zazachubin/RD53B_Quad_6DP_to_ERF8_Data_Adapter/Docs/Design/PCB_Design/6DP_to_ERF8_pcb_GND.png

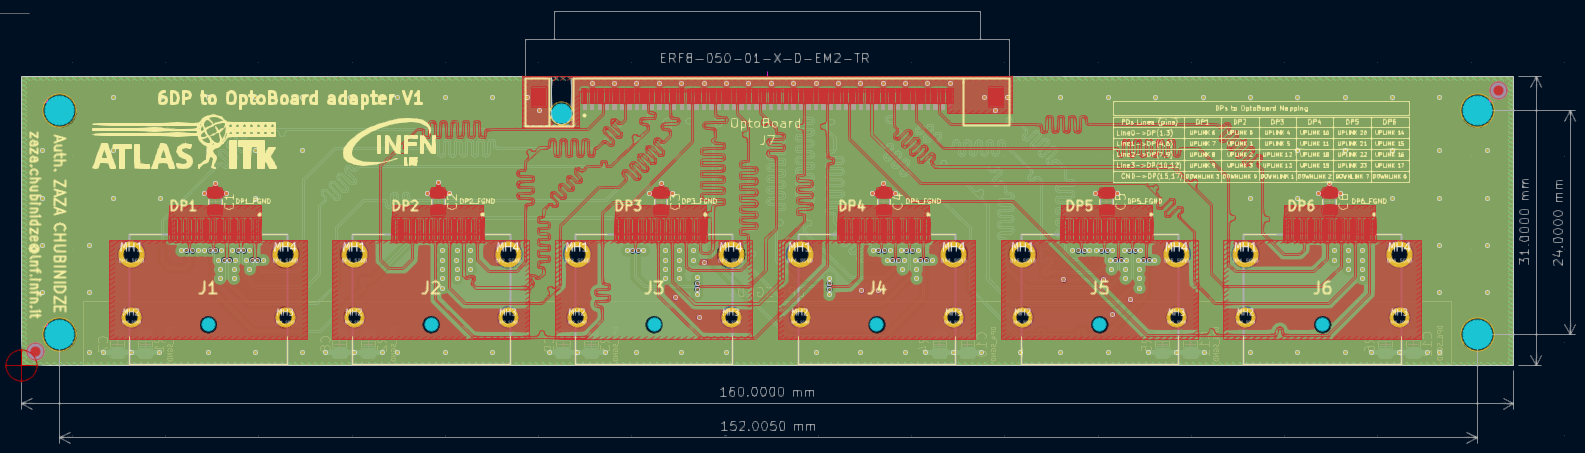
Docs/Design/PCB_Design/6DP_to_ERF8_pcb_GND.png
