zazachubin/RD53B_Quad_6DP_to_ERF8_Data_Adapter/Production/Panel_Board_Gerber/Panelization_bom.csv

Id | Designator | Footprint | Quantity | Designation | Supplier and ref
1 | ,,,,,,,,,,,,,,,,,,,,,,,,,,,,,,, |  | 32
2 | C2,C2,C2,C2,C2,C2,C2,C2,C1,C1,C1,C1,C1,C1,C1,C1,C6,C6,C6,C6,C6,C6,C6,C6,C3,C3,C3,C3,C3,C3,C3,C3,C5,C5,C5,C5,C5,C5,C5,C5,C4,C4,C4,C4,C4,C4,C4,C4,C12,C12,C12,C12,C12,C12,C12,C12,C8,C8,C8,C8,C8,C8,C8,C8,C7,C7,C7,C7,C7,C7,C7,C7,C9,C9,C9,C9,C9,C9,C9,C9,C11,C11,C11,C11,C11,C11,C11,C11,C10,C10,C10,C10,C10,C10,C10,C10 | C_0805_2012Metric | 96 | 0.1uF
3 | J4,J4,J4,J4,J4,J4,J4,J4,J2,J2,J2,J2,J2,J2,J2,J2,J6,J6,J6,J6,J6,J6,J6,J6,J5,J5,J5,J5,J5,J5,J5,J5,J3,J3,J3,J3,J3,J3,J3,J3,J1,J1,J1,J1,J1,J1,J1,J1 | 472720024 | 48 | 47272-0024
4 | REF**,REF**,REF**,REF**,REF**,REF** | Fiducial | 6 | Fiducial
5 | J7,J7,J7,J7,J7,J7,J7,J7 | SAMTEC_ERF8-050-01-X-D-EM2-TR | 8 | ERF8-050-01-X-D-EM2-TR
6 | REF_Top,REF_Top,REF_Top,REF_Top,REF_Top,REF_Top,REF_Top,REF_Top,REF_Top,REF_Top,REF_Top,REF_Top,REF_Top,REF_Top,REF_Top,REF_Top,REF_Bottom,REF_Bottom,REF_Bottom,REF_Bottom,REF_Bottom,REF_Bottom,REF_Bottom,REF_Bottom,REF_Bottom,REF_Bottom,REF_Bottom,REF_Bottom,REF_Bottom,REF_Bottom,REF_Bottom,REF_Bottom | Fiducial_1mm_Mask2mm | 32 | Fiducial_1mm_Mask2mm
7 | R3,R3,R3,R3,R3,R3,R3,R3,R6,R6,R6,R6,R6,R6,R6,R6,R4,R4,R4,R4,R4,R4,R4,R4,R2,R2,R2,R2,R2,R2,R2,R2,R1,R1,R1,R1,R1,R1,R1,R1,R5,R5,R5,R5,R5,R5,R5,R5 | R_0805_2012Metric | 48 | 10k
