zazachubin/RD53B_Quad_6DP_to_ERF8_Data_Adapter/Production/Single_Board_Gerber/RD53B_Quad_6DP_to_ERF8_Data_Adapter_Bom.csv

Id | Designator | Footprint | Quantity | Designation | Supplier and ref
1 | ,,, |  | 4
2 | C2,C1,C6,C3,C5,C4,C12,C8,C7,C9,C11,C10 | C_0805_2012Metric | 12 | 0.1uF
3 | J4,J2,J6,J5,J3,J1 | 472720024 | 6 | 47272-0024
4 | J7 | SAMTEC_ERF8-050-01-X-D-EM2-TR | 1 | ERF8-050-01-X-D-EM2-TR
5 | REF_Top,REF_Top,REF_Bottom,REF_Bottom | Fiducial_1mm_Mask2mm | 4 | Fiducial_1mm_Mask2mm
6 | R3,R6,R4,R2,R1,R5 | R_0805_2012Metric | 6 | 10k
