zazachubin/RD53B_Quad_6DP_to_ERF8_Data_Adapter/Docs/Design/3D_PCB/6DP_to_ERF8_PCB_front_without_components.png

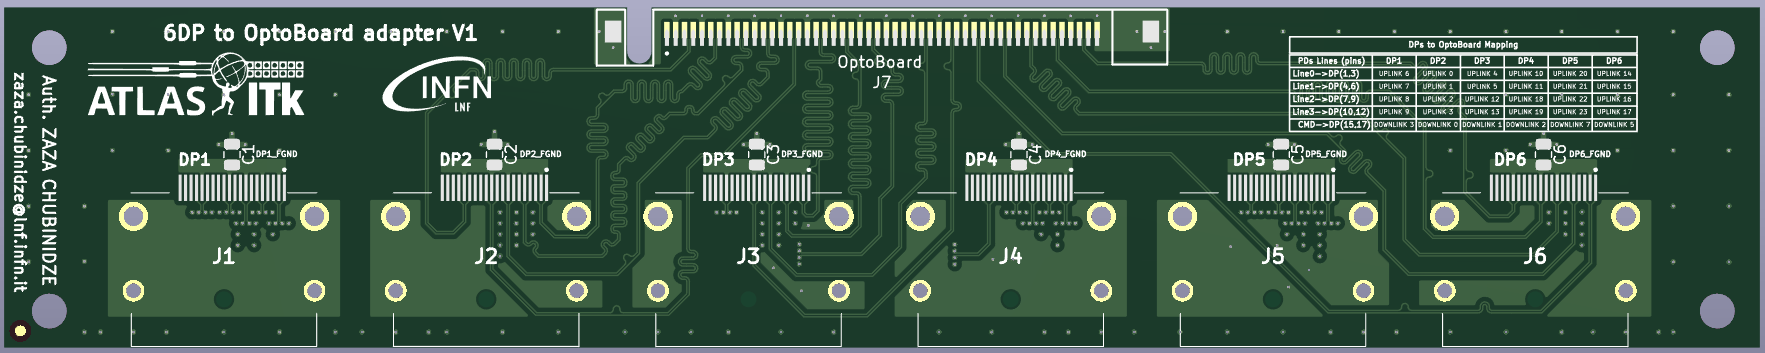
Docs/Design/3D_PCB/6DP_to_ERF8_PCB_front_without_components.png
