zazachubin/RD53B_Quad_6DP_to_ERF8_Data_Adapter/Docs/Design/Schematic/v1/RD53B_Quad_6DP_to_ERF8_Data_Adapter.pdf

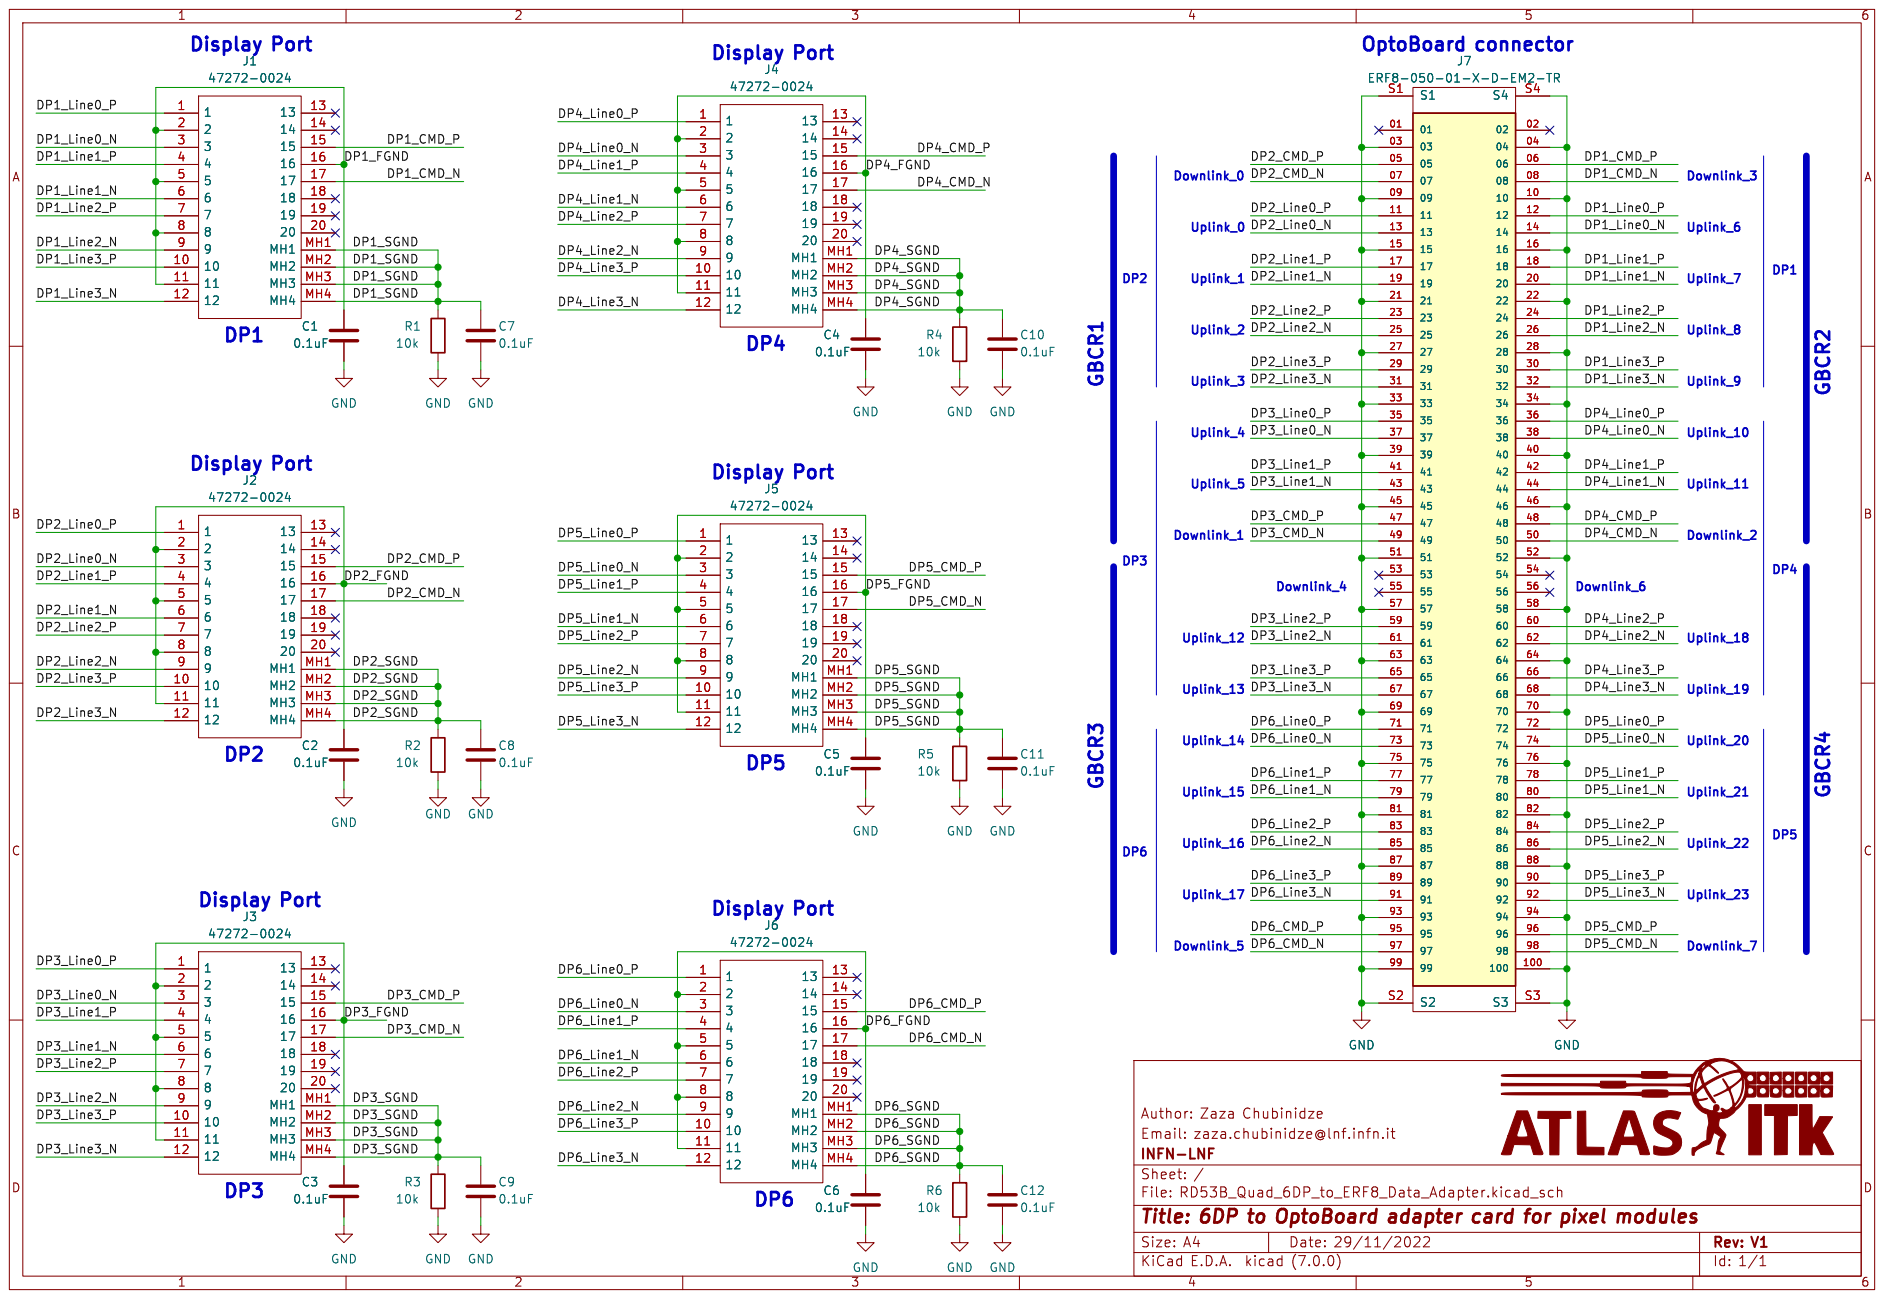
[picture p7: page 1]

INFN-LNF Email: zaza.chubinidze@lnf.infn.it Author: Zaza Chubinidze R3

File: RD53B_Quad_6DP_to_ERF8_Data_Adapter.kicad_sch Sheet: /
Id: 1/1 Title: 6DP to OptoBoard adapter card for pixel modules
