zazachubin/RD53B_Quad_6DP_to_ERF8_Data_Adapter/Docs/Design/Schematic/v0/RD53B_Quad_6DP_to_ERF8_Data_Adapter.pdf

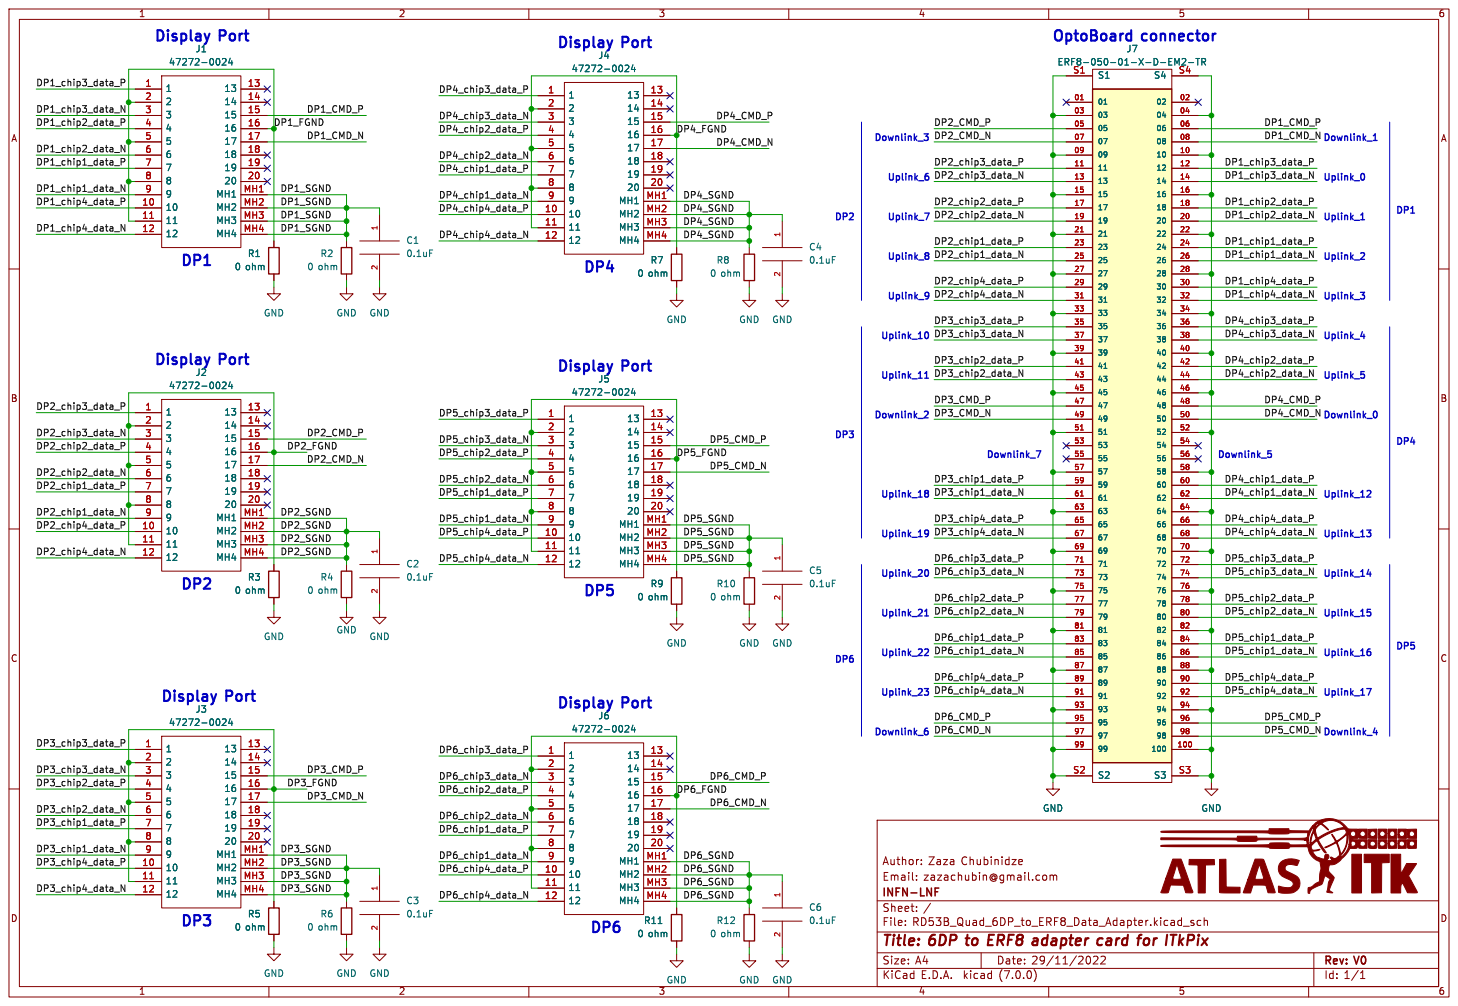
[picture p8: page 1]

INFN-LNF Email: zazachubin@gmail.com

File: RD53B_Quad_6DP_to_ERF8_Data_Adapter.kicad_sch Sheet: /
Id: 1/1 Title: 6DP to ERF8 adapter card for ITkPix
