zazachubin/RD53B_Quad_6DP_to_ERF8_Data_Adapter/Docs/Production Guide.pptx

## Single board PCB Design

6DP to OptoBoard Adapter Card

Top View

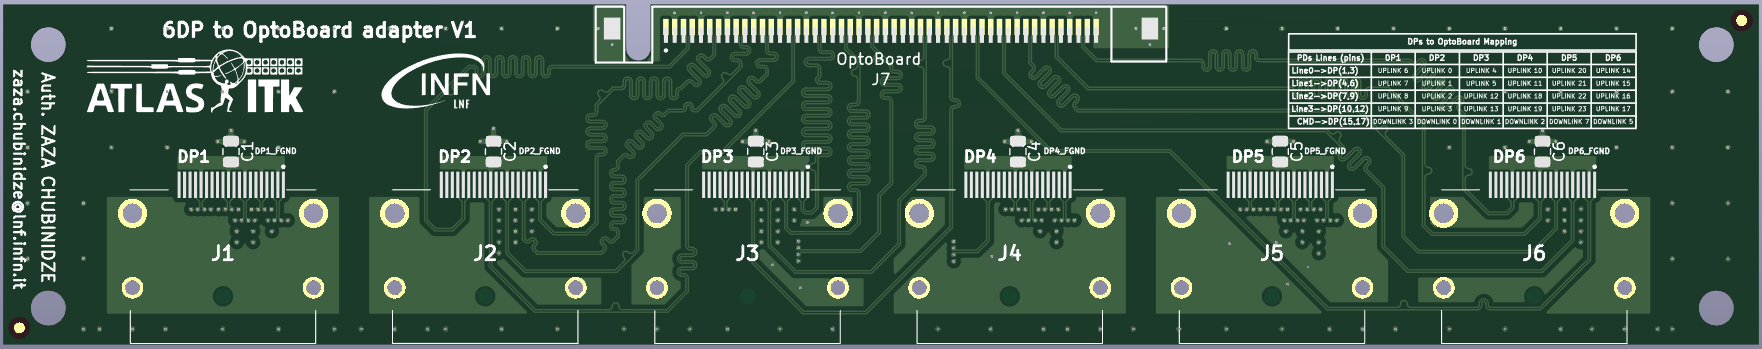
[picture p12: figure]
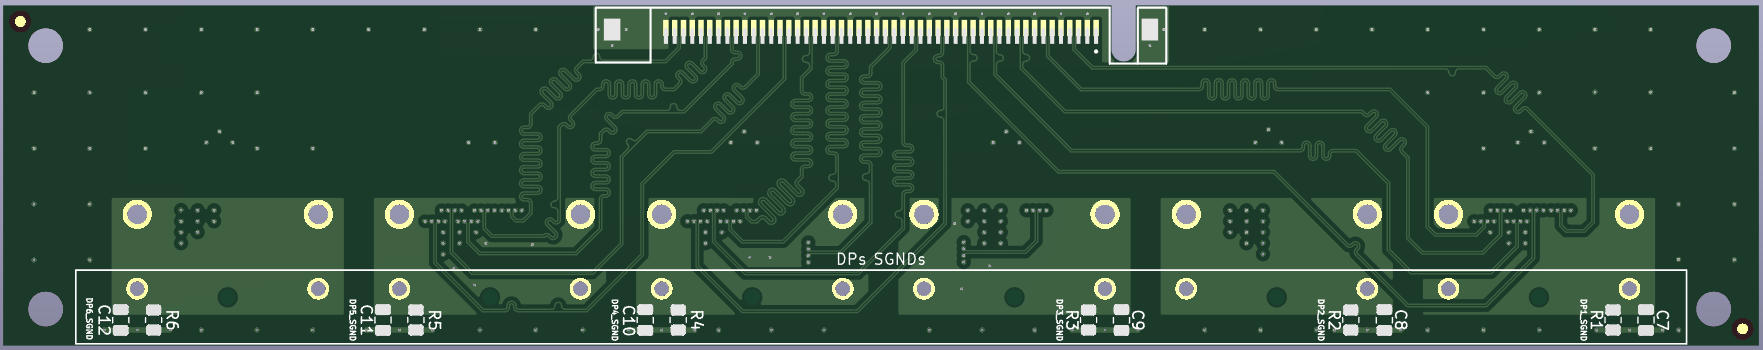
[picture p13: figure]

Bottom View

## Single board Assembly

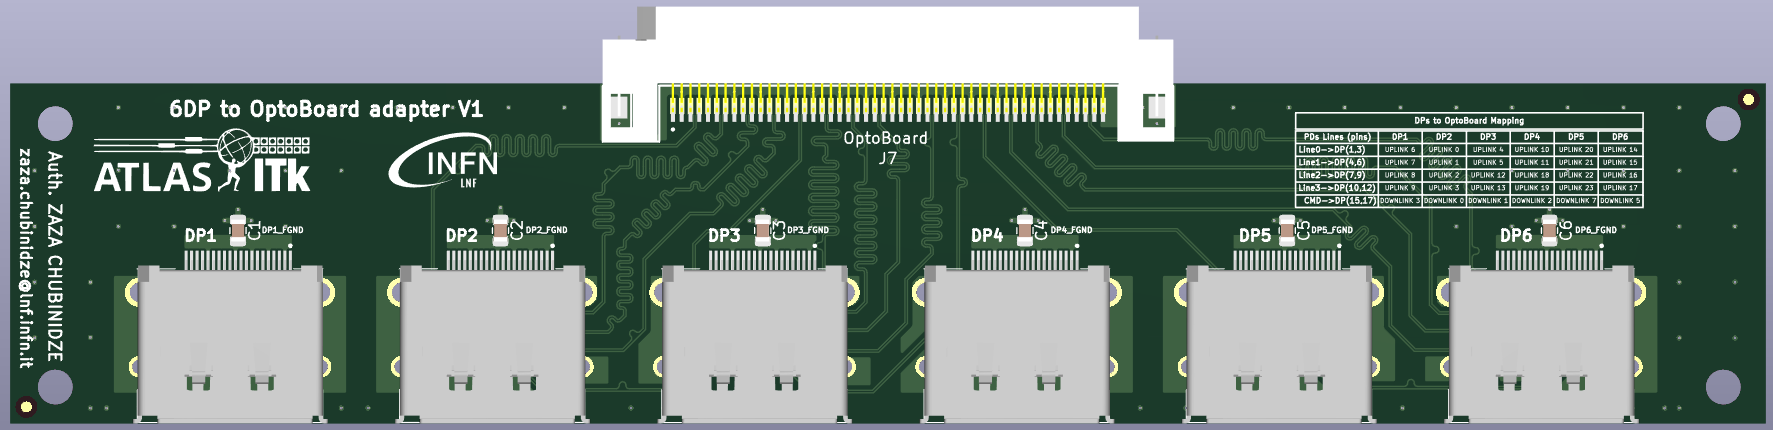
[picture p14: figure]

Top View

ERF8-050-01-L-D-EM2-TR connector

DP

DP

DP

DP

DP

DP

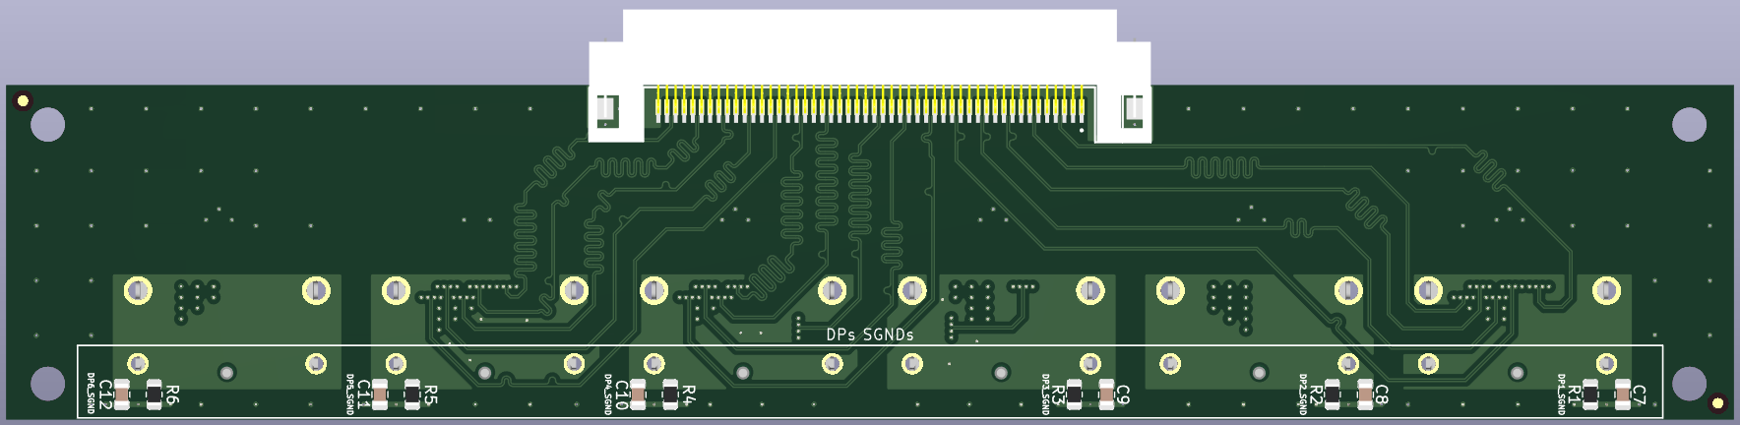
[picture p15: figure]

Bottom View

ERF8-050-01-L-D-EM2-TR connector

## PCB production requirements

KiCAD PCB Layer StackUp

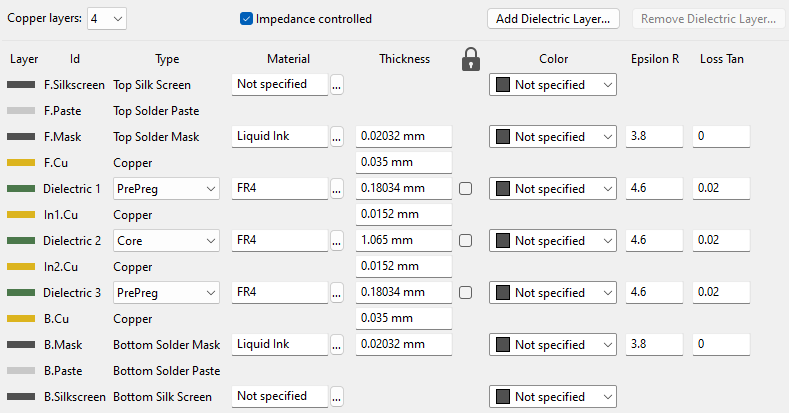
[picture p16: figure]

Components for assembly
- C1, C2, C3, C4, C5, C6, C7, C8, C9, C10, C11, C12 --- 0.1uF SMD Capacitor (Package: C_0805)
- R1, R2, R3, R4, R5, R6 --- 10K SMD Resistance (Package: R_0805)
- J1, J2, J3, J4, J5, J6 --- DISPLAYPORT 20P SMD RA (Molex_472720024)
- J7 --- ERF8-050-01-L-D-EM2-TR

JLCPCB Standard

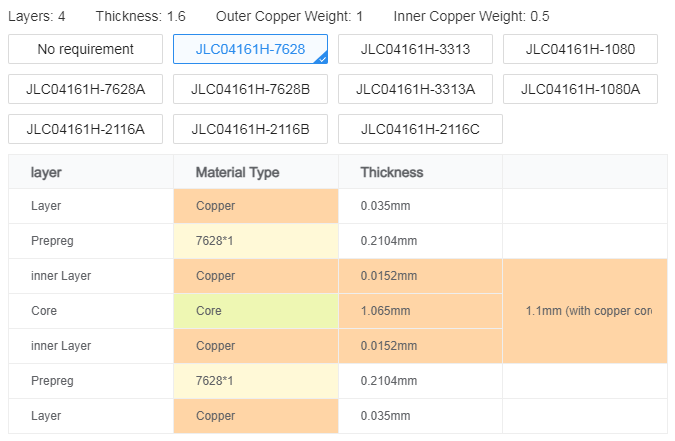
[picture p17: figure]
