zazachubin/RD53B_Quad_6DP_to_ERF8_Data_Adapter/(commit log)

2023-01-20 Initial project
    [RD53B_Quad_6DP_to_ERF8_Data_Adapter.kicad_pcb, RD53B_Quad_6DP_to_ERF8_Data_Adapter.kicad_sch]
2023-01-25 Add DPs shield capacitors
    [RD53B_Quad_6DP_to_ERF8_Data_Adapter.kicad_pcb, RD53B_Quad_6DP_to_ERF8_Data_Adapter.kicad_sch]
2023-01-26 Display ports floating GND optimization
    [RD53B_Quad_6DP_to_ERF8_Data_Adapter.kicad_pcb, RD53B_Quad_6DP_to_ERF8_Data_Adapter.kicad_sch]
2023-01-28 traces length matching for DP1,DP6
    [RD53B_Quad_6DP_to_ERF8_Data_Adapter.kicad_pcb]
2023-01-29 traces length matching for DP2
    [RD53B_Quad_6DP_to_ERF8_Data_Adapter.kicad_pcb]
2023-01-29 traces length matching for DP5
    [RD53B_Quad_6DP_to_ERF8_Data_Adapter.kicad_pcb]
2023-01-29 traces length matching for DP3
    [RD53B_Quad_6DP_to_ERF8_Data_Adapter.kicad_pcb]
2023-01-29 traces length matching for DP4
    [RD53B_Quad_6DP_to_ERF8_Data_Adapter.kicad_pcb]
2023-02-02 Revision 1
    [RD53B_Quad_6DP_to_ERF8_Data_Adapter.kicad_pcb]
2023-02-05 Add fiducial marker
    [RD53B_Quad_6DP_to_ERF8_Data_Adapter.kicad_pcb]
2023-02-05 ERF8 connector GND layout modifie
    [RD53B_Quad_6DP_to_ERF8_Data_Adapter.kicad_pcb]
2023-02-06 Revision 2
    [RD53B_Quad_6DP_to_ERF8_Data_Adapter.kicad_pcb]
2023-02-12 Add return ground vias
    [RD53B_Quad_6DP_to_ERF8_Data_Adapter.kicad_pcb]
2023-02-17 Add PCB production files
    [RD53B_Quad_6DP_to_ERF8_Data_Adapter.kicad_pcb]
2023-02-20 Update KiCad version 7.0
    [RD53B_Quad_6DP_to_ERF8_Data_Adapter.kicad_pcb, RD53B_Quad_6DP_to_ERF8_Data_Adapter.kicad_sch]
2023-05-08 Update mapping
    [RD53B_Quad_6DP_to_ERF8_Data_Adapter.kicad_pcb, RD53B_Quad_6DP_to_ERF8_Data_Adapter.kicad_sch]
2023-06-22 update version v1
    [RD53B_Quad_6DP_to_ERF8_Data_Adapter.kicad_pcb, RD53B_Quad_6DP_to_ERF8_Data_Adapter.kicad_sch]
2023-07-11 Update project SMD components for SP mode
    [RD53B_Quad_6DP_to_ERF8_Data_Adapter.kicad_pcb, RD53B_Quad_6DP_to_ERF8_Data_Adapter.kicad_sch]
2023-07-13 add Single board production gerber files
    [RD53B_Quad_6DP_to_ERF8_Data_Adapter-B_Adhesive.gbr, RD53B_Quad_6DP_to_ERF8_Data_Adapter-B_Courtyard.gbr, RD53B_Quad_6DP_to_ERF8_Data_Adapter-B_Cu.gbr, RD53B_Quad_6DP_to_ERF8_Data_Adapter-B_Fab.gbr, RD53B_Quad_6DP_to_ERF8_Data_Adapter-B_Mask.gbr, RD53B_Quad_6DP_to_ERF8_Data_Adapter-B_Paste.gbr, RD53B_Quad_6DP_to_ERF8_Data_Adapter-B_Silkscreen.gbr, RD53B_Quad_6DP_to_ERF8_Data_Adapter-Edge_Cuts.gbr]
2023-07-13 Update single board gerber files
    [RD53B_Quad_6DP_to_ERF8_Data_Adapter-B_Adhesive.gbr, RD53B_Quad_6DP_to_ERF8_Data_Adapter-B_Courtyard.gbr, RD53B_Quad_6DP_to_ERF8_Data_Adapter-B_Cu.gbr, RD53B_Quad_6DP_to_ERF8_Data_Adapter-B_Fab.gbr, RD53B_Quad_6DP_to_ERF8_Data_Adapter-B_Mask.gbr, RD53B_Quad_6DP_to_ERF8_Data_Adapter-B_Paste.gbr, RD53B_Quad_6DP_to_ERF8_Data_Adapter-B_Silkscreen.gbr, RD53B_Quad_6DP_to_ERF8_Data_Adapter-Edge_Cuts.gbr]
2023-07-13 add Panel board production gerber files
    [Panelization-B_Adhesive.gbr, Panelization-B_Courtyard.gbr, Panelization-B_Cu.gbr, Panelization-B_Fab.gbr, Panelization-B_Mask.gbr, Panelization-B_Paste.gbr, Panelization-B_Silkscreen.gbr, Panelization-Edge_Cuts.gbr]
2023-07-13 Update PCB Panel production format
    [Panelization-B_Adhesive.gbr, Panelization-B_Courtyard.gbr, Panelization-B_Cu.gbr, Panelization-B_Fab.gbr, Panelization-B_Mask.gbr, Panelization-B_Paste.gbr, Panelization-B_Silkscreen.gbr, Panelization-Edge_Cuts.gbr]
2023-07-14 add fiducial sign
    [RD53B_Quad_6DP_to_ERF8_Data_Adapter.kicad_pcb]
2023-07-14 Update Gerber files
    [Panelization-B_Cu.gbr, Panelization-B_Mask.gbr, Panelization-B_Paste.gbr, Panelization-B_Silkscreen.gbr, Panelization-Edge_Cuts.gbr, Panelization-F_Cu.gbr, Panelization-F_Mask.gbr, Panelization-F_Paste.gbr]
2023-11-07 add v0 schematic pdf file
